tlsgksrb/AUTORY-26th/output/summary.md

# 프레임 해석 결과 요약 (자동 생성)

`python run_frame.py` 실행 결과. 수치는 `frame/config.py` 입력값 기준.

- 재료: STKM13C (KS D 3517)
- 프레임 질량: 39.33 kg (튜브만 35.75 kg + 용접·탭 10 %)
- 비틀림 강성: **2020 N·m/deg** (51.4 N·m/deg/kg)
- 차량 질량(드라이버 포함, 가정): 246.3 kg, 앞축 하중 41.7 %
- 무게중심 (X, Y, Z): [903.7, -0.1, 208.6] mm
- 부재: 해석 구간 107개 = 실제 튜브 77개 (굽힘 후프는 1개, 일직선으로 이어지는 레일은 1개로 계산)
- 프레임 외곽: 길이 2170 × 폭 570 × 높이 1200 mm

## 하중 조건별 결과

| 조건 | 최대 변위 (mm) | 최소 안전율 | 취약 부재 | 최대 좌굴 이용률 |
|---|---:|---:|---|---:|
| 비틀림 강성 | 4.91 | 2.15 | FU_b_R-FH_mid_R (전방 벌크헤드 지지) | 0.12 |
| 정적 1 g 굽힘 | 0.2 | 22.81 | LR_m_L-LRX_C (랩·안티서브 벨트 가로재) | 0.005 |
| 범프 3 g | 0.59 | 7.6 | LR_m_L-LRX_C (랩·안티서브 벨트 가로재) | 0.014 |
| 제동 1.5 g + 선회 1.5 g + 1 g | 0.88 | 6.08 | FH_bot_L-LR_m_L (측면 충격구조) | 0.046 |
| 메인 롤후프(전복) | 5.55 | 1.05 | MH_mid_L-RU_a_L (후방 프레임(모터 베이)) | 0.26 |
| 전방 롤후프(전복) | 4.13 | 1.05 | FH_up_L-FH_top_L (전방 롤후프) | 0.192 |
| 측면 충돌 7 kN | 5.94 | 1.36 | SU_m_L-FH_up_L (기타 프레임재) | 0.106 |
| 전면 충돌 20 g (48.3 kN) | 5.57 | 1.43 | MH_mid_L-RU_a_L (후방 프레임(모터 베이)) | 0.189 |
| 후면 충돌 20 g (48.3 kN) | 1.93 | 1.2 | MH_mid_L-RU_a_L (후방 프레임(모터 베이)) | 0.085 |
| 6점식 벨트 하중 (17.7 kN) | 7.37 | 1.27 | MH_sh_L-SH_L (어깨벨트 바) | 0.104 |

## 체크리스트

| 항목 | 값 | 기준 | 판정 |
|---|---:|---|:---:|
| 휠베이스 | 1550.0 mm | ≥ 1500 | OK |
| 타이어 폭(가정 타이어) | 203.0 mm | ≥ 200 | OK |
| 튜브 규격 · 메인 롤후프 | Ø25.4×2.3  | ≥ Ø25×1.8 | OK |
| 튜브 규격 · 전방 롤후프 | Ø31.8×2  | ≥ Ø25×1.8 | OK |
| 튜브 규격 · 어깨벨트 바 | Ø25.4×2.3  | ≥ Ø25×1.8 | OK |
| 튜브 규격 · 메인 롤후프 지지대 | Ø25.4×1.6  | ≥ Ø25×1.6 | OK |
| 튜브 규격 · 어깨벨트 바 지지 | Ø25.4×1.6  | ≥ Ø25×1.6 | OK |
| 튜브 규격 · 전방 롤후프 지지대 | Ø25.4×1.6  | ≥ Ø25×1.6 | OK |
| 튜브 규격 · 측면 충격구조 | Ø25.4×1.6  | ≥ Ø25×1.6 | OK |
| 튜브 규격 · 랩·안티서브 벨트 가로재 | Ø25.4×1.6  | ≥ Ø25×1.6 | OK |
| 튜브 규격 · 전방 벌크헤드 | Ø25.4×1.6  | ≥ Ø25×1.6 | OK |
| 튜브 규격 · 전방 벌크헤드 지지 | Ø25.4×1.6  | ≥ Ø25×1.6 | OK |
| 튜브 규격 · 후방 벌크헤드·후방 지지 | Ø25.4×1.6  | ≥ Ø25×1.6 | OK |
| 튜브 규격 · 후방 프레임(모터 베이) | Ø22.2×1.2  | ≥ Ø20×1.2 | OK |
| 튜브 규격 · 기타 프레임재 | Ø22.2×1.2  | ≥ Ø20×1.2 | OK |
| 재료 항복강도 | 380.0 MPa | ≥ 285 | OK |
| 재료 인장강도 | 510.0 MPa | ≥ 360 | OK |
| 헬멧 ~ 롤후프 연결선 여유 | 60.3 mm | ≥ 50.8 | OK |
| 헬멧 뒤 ~ 메인 후프 앞면 (헤드레스트 공간) | 63.9 mm | ≥ 40 (패드+간격, 자체) | OK |
| 메인 후프 상단 - 헬멧 상단 | 193.2 mm | > 0 | OK |
| 메인 후프-지지대 각도(측면도) | 30.6 deg | ≥ 30 | OK |
| 지지대 부착점 ~ 후프 최상단 | 32.7 mm | ≤ 160 | OK |
| 전방 후프 상단 - 스티어링 휠 상단 | 25.0 mm | ≥ 0 | OK |
| 전방 후프가 휠보다 앞선 거리 | 70.0 mm | ≤ 250 | OK |
| 무릎 상단(+60) ~ 전방 후프 상단 | 229.4 mm | > 0 | OK |
| 무릎 ~ 프레임 튜브 최소 간격 [FH_up_L-FH_up_R] | 62.0 mm | ≥ 25 (자체) | OK |
| 헬멧 ~ 프레임 튜브 최소 간격 [MH_sh_R-MH_top_L] | 75.5 mm | ≥ 25 (자체) | OK |
| 어깨벨트 각도(수평 기준, +위) | -2.2 deg | -20 ~ +10 | OK |
| 어깨벨트 마운트 간격 | 190.0 mm | 178 ~ 229 | OK |
| 랩벨트 각도(측면도) | 53.8 deg | 45 ~ 65 | OK |
| 프레임 최저지상고 | 52.3 mm | ≥ 40 | OK |
| 6점식 벨트 마운트 노드(어깨2·랩2·안티서브) | 있음  | 필수 | OK |
| 전·후면 범퍼(충격완화장치) 마운트면 | 전방/후방 벌크헤드  | 필수 | OK |
| 해석 · 범프 3 g 안전율 | 7.6 - | ≥ 1.5 (좌굴 이용률 ≤ 0.67) | OK |
| 해석 · 제동 1.5 g + 선회 1.5 g + 1 g 안전율 | 6.08 - | ≥ 1.5 (좌굴 이용률 ≤ 0.67) | OK |
| 해석 · 메인 롤후프(전복) 안전율 | 1.05 - | ≥ 1 (좌굴 이용률 ≤ 1) | OK |
| 해석 · 메인 롤후프(전복) 최대 변위 | 5.55 mm | ≤ 25 | OK |
| 해석 · 전방 롤후프(전복) 안전율 | 1.05 - | ≥ 1 (좌굴 이용률 ≤ 1) | OK |
| 해석 · 전방 롤후프(전복) 최대 변위 | 4.13 mm | ≤ 25 | OK |
| 해석 · 측면 충돌 7 kN 안전율 | 1.36 - | ≥ 1 (좌굴 이용률 ≤ 1) | OK |
| 해석 · 측면 충돌 7 kN 최대 변위 | 5.94 mm | ≤ 25 | OK |
| 해석 · 전면 충돌 20 g (48.3 kN) 안전율 | 1.43 - | ≥ 1 (좌굴 이용률 ≤ 1) | OK |
| 해석 · 후면 충돌 20 g (48.3 kN) 안전율 | 1.2 - | ≥ 1 (좌굴 이용률 ≤ 1) | OK |
| 해석 · 6점식 벨트 하중 (17.7 kN) 안전율 | 1.27 - | ≥ 1 (좌굴 이용률 ≤ 1) | OK |
| 해석 · 비틀림 강성 | 2020 N·m/deg | ≥ 1500 | OK |
| 프레임 질량(용접·탭 +10 %) | 39.3 kg | ≤ 35 | **NG** |

## 강관 소요량

| 규격 | 개수 | 총 길이 (m) | 질량 (kg) | 6 m 정척(손실 15 %) |
|---|---:|---:|---:|---:|
| Ø31.8×2 | 8 | 1.7 | 2.5 | 1 |
| Ø25.4×2.3 | 11 | 3.14 | 4.11 | 1 |
| Ø25.4×1.6 | 54 | 21.71 | 20.39 | 5 |
| Ø22.2×1.2 | 34 | 14.09 | 8.76 | 3 |
