tlsgksrb/AUTORY-26th/output/frame_centerlines.dxf

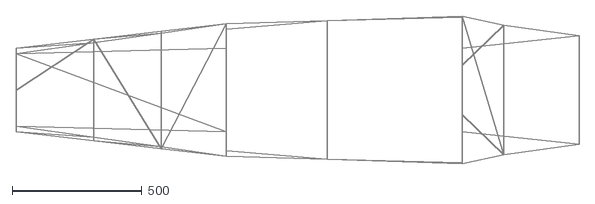
[picture p4: CAD file, 2026-11-05]
output/frame_centerlines.dxf
2170.0 x 570.0
