tlsgksrb/AUTORY-26th/(commit log)

2026-11-05 Add parametric space-frame design v0.1 for 2027 e-mobility competition
    - Parametric steel tube space frame (nodes/members, symmetric) with
    95th driver template, packaging zones and reinforcement options
    - 3D beam/truss linear static solver (numpy) with verification tests
    - 10 load cases: torsion, 1 g, 3 g bump, brake+corner, main/front hoop
    rollover, side/front/rear impact, 6-point harness
    - Rule/geometry checklist with source and confirmation status per rule
    - Outputs: overview/safety-factor/deformation plots, node and cut-list
    CSV, BOM, 3D centerline DXF, viewer JSON
    - Korean design report (docs/프레임_설계보고서.md)
    Cl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
    [cut_list.csv, frame_centerlines.dxf, nodes.csv]
2026-11-05 Add interactive 3D frame viewer and coordinate-system note
    - build_viewer.py renders viewer/index.html from the analysis results
    (orbit/zoom canvas, group or per-load-case safety-factor coloring,
    driver template, packaging zones, checklist, BOM)
    - Document that the X-rear/Y-left/Z-up axes are left-handed
    Claude-Session: https://claude.ai/code/session_01UgnkKu3Bzub2pC5R6TTkuR
2026-11-05 Trim frame to v0.2 after member-removal study (82 -> 77 tubes)
    - prune_study.py: greedy symmetric member removal that keeps every
    check (torsion >= 1800 N·m/deg, operating SF >= 1.5, crash SF >= 1.05)
    - Drop cockpit rails, motor-bay top cross, rear bulkhead diagonal and
    rear floor diagonal (now Params options, default off):
    41.9 -> 39.3 kg, 2186 -> 2020 N·m/deg, all checks still pass
    - Report physical tube count (bent hoops and collinear rails count once)
    - Hide analysis-only suspension links in 2D drawings
    - Update report section 5-1 with the study and why further removal
    is blocked by the rollover/impact load cases
    Claude-S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
    [cut_list.csv, frame_centerlines.dxf]
